sfambach/PALDump/hardware/shield/paldump-shield-bottom.png

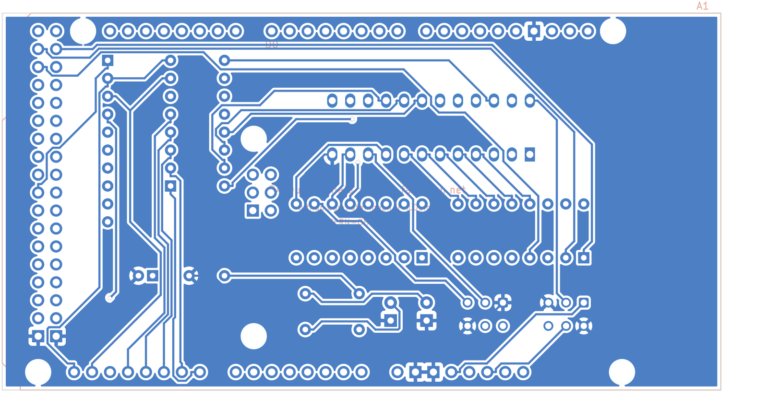
hardware/shield/paldump-shield-bottom.png
