sfambach/PALDump/hardware/shield/paldump-shield-schematic.png

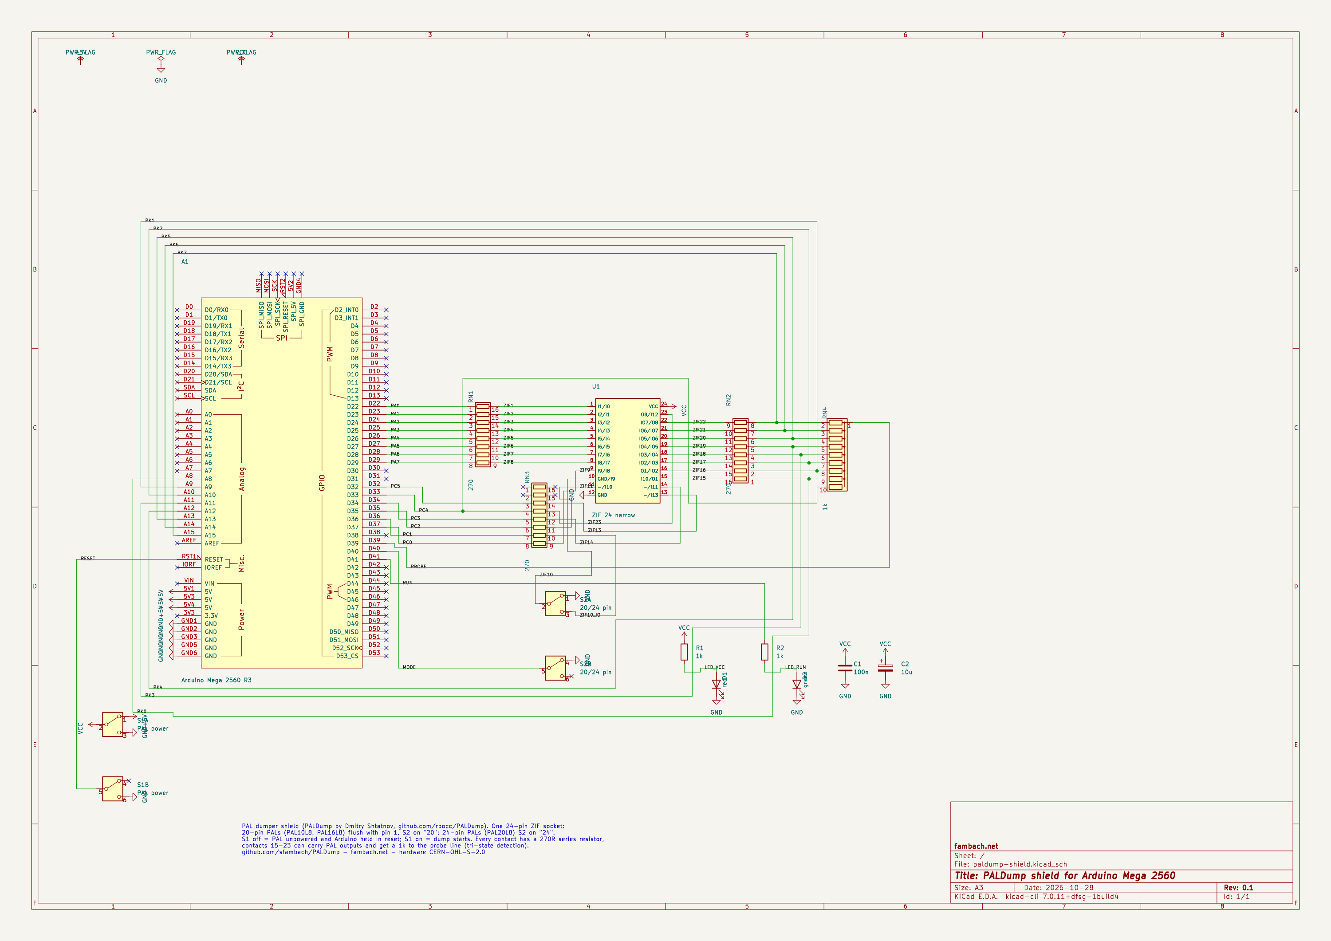
hardware/shield/paldump-shield-schematic.png
