sfambach/PALDump/hardware/shield/paldump-shield-schematic.pdf

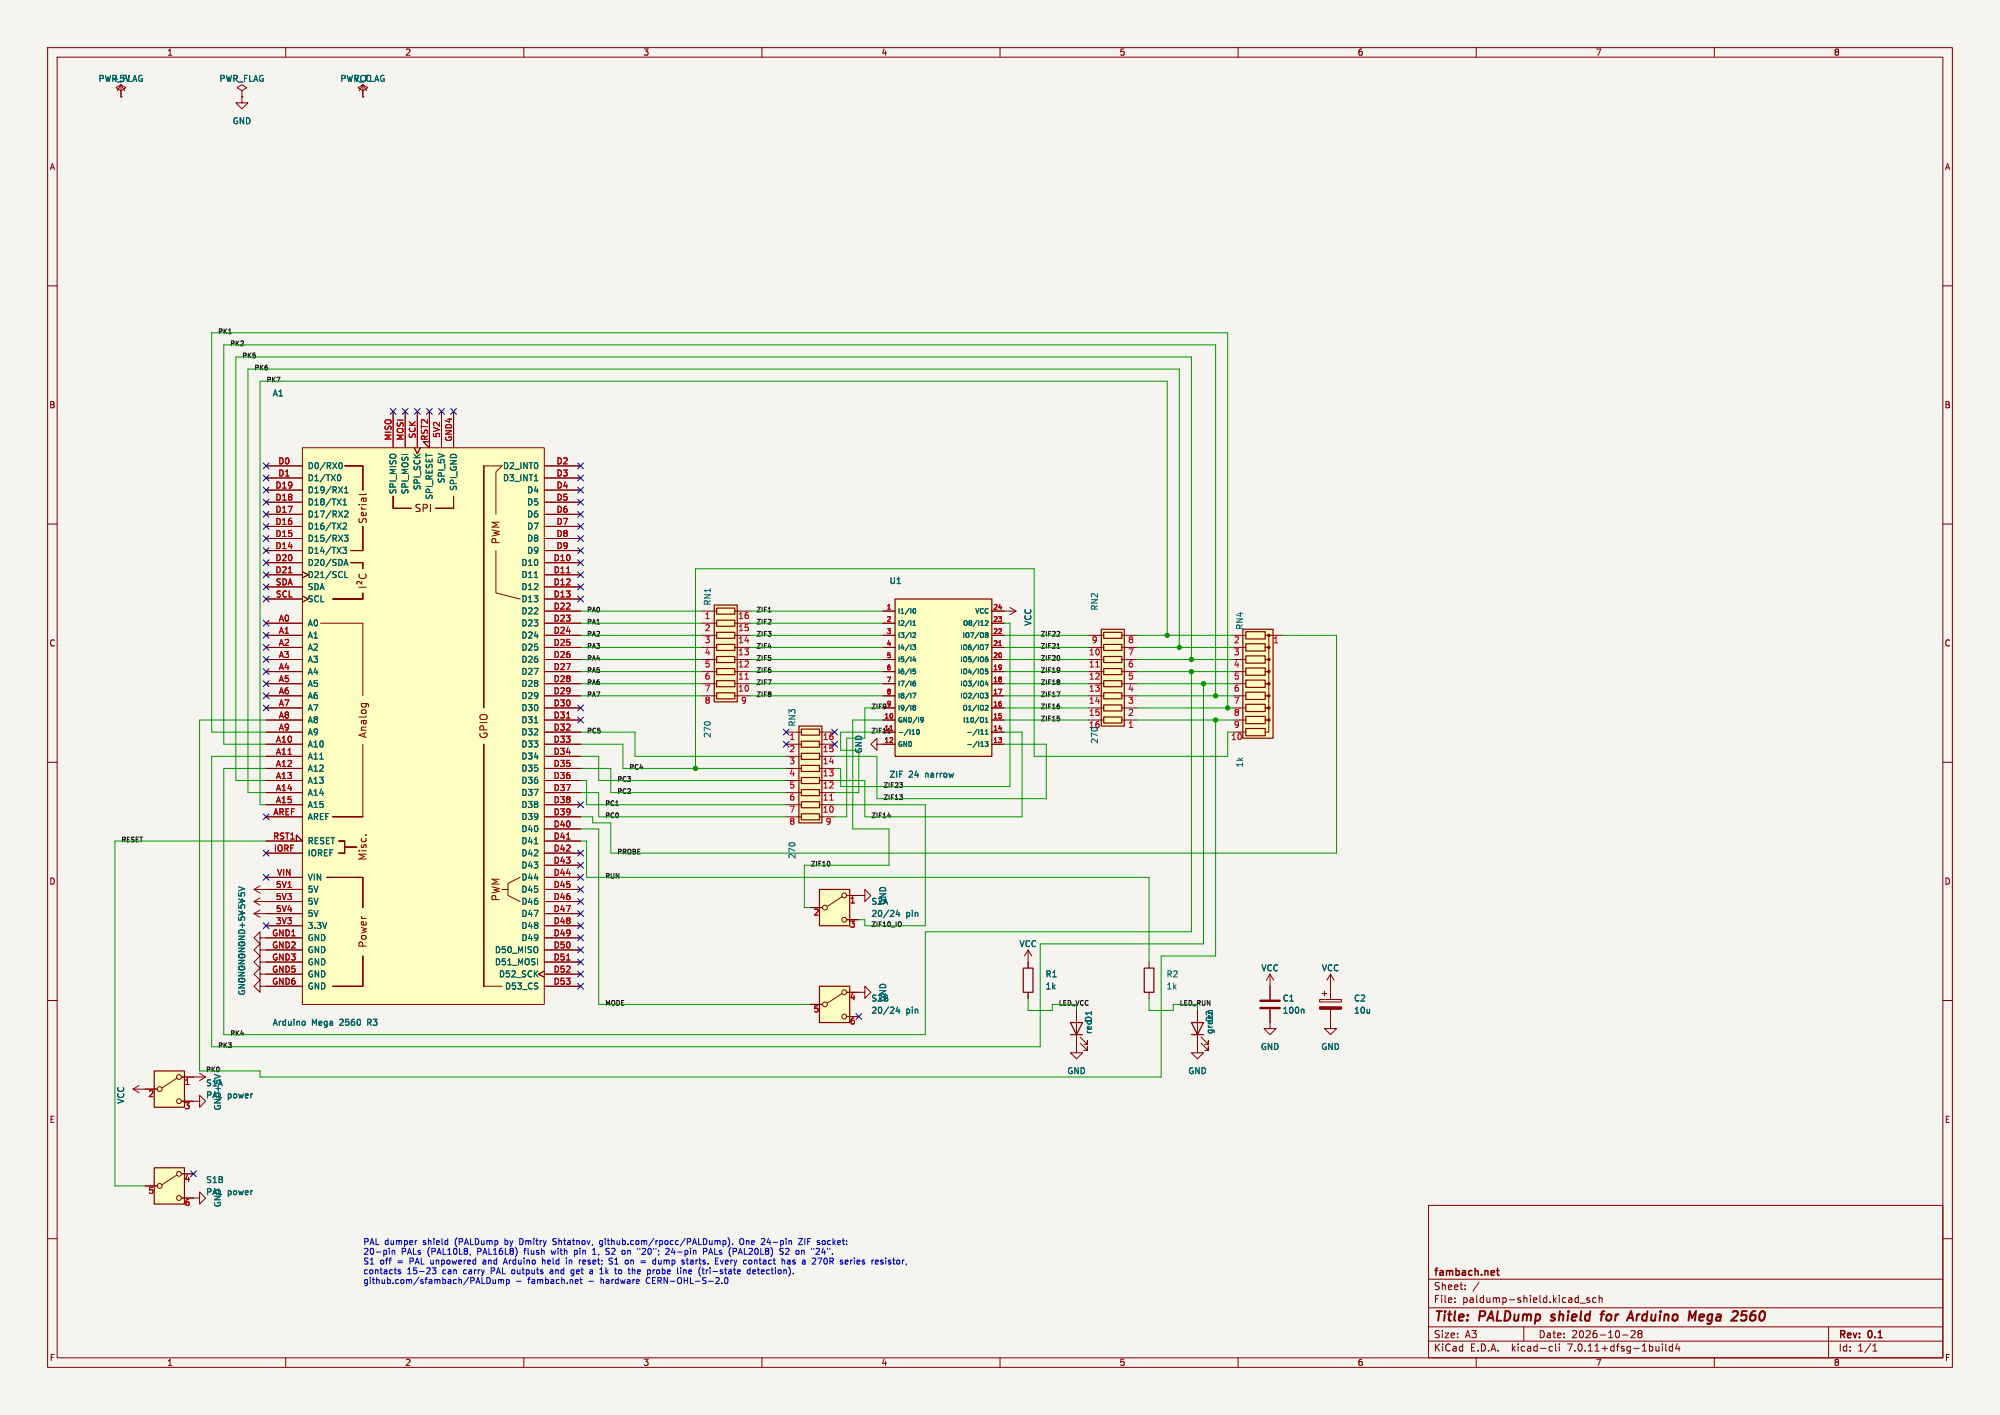
[picture p4: page 1]

Id: 1/1 Title: PALDump shield for Arduino Mega 2560
