sfambach/PALDump/hardware/shield/paldump-shield.kicad_pcb

## KiCad design hardware/shield/paldump-shield.kicad_pcb (2026-10-28)

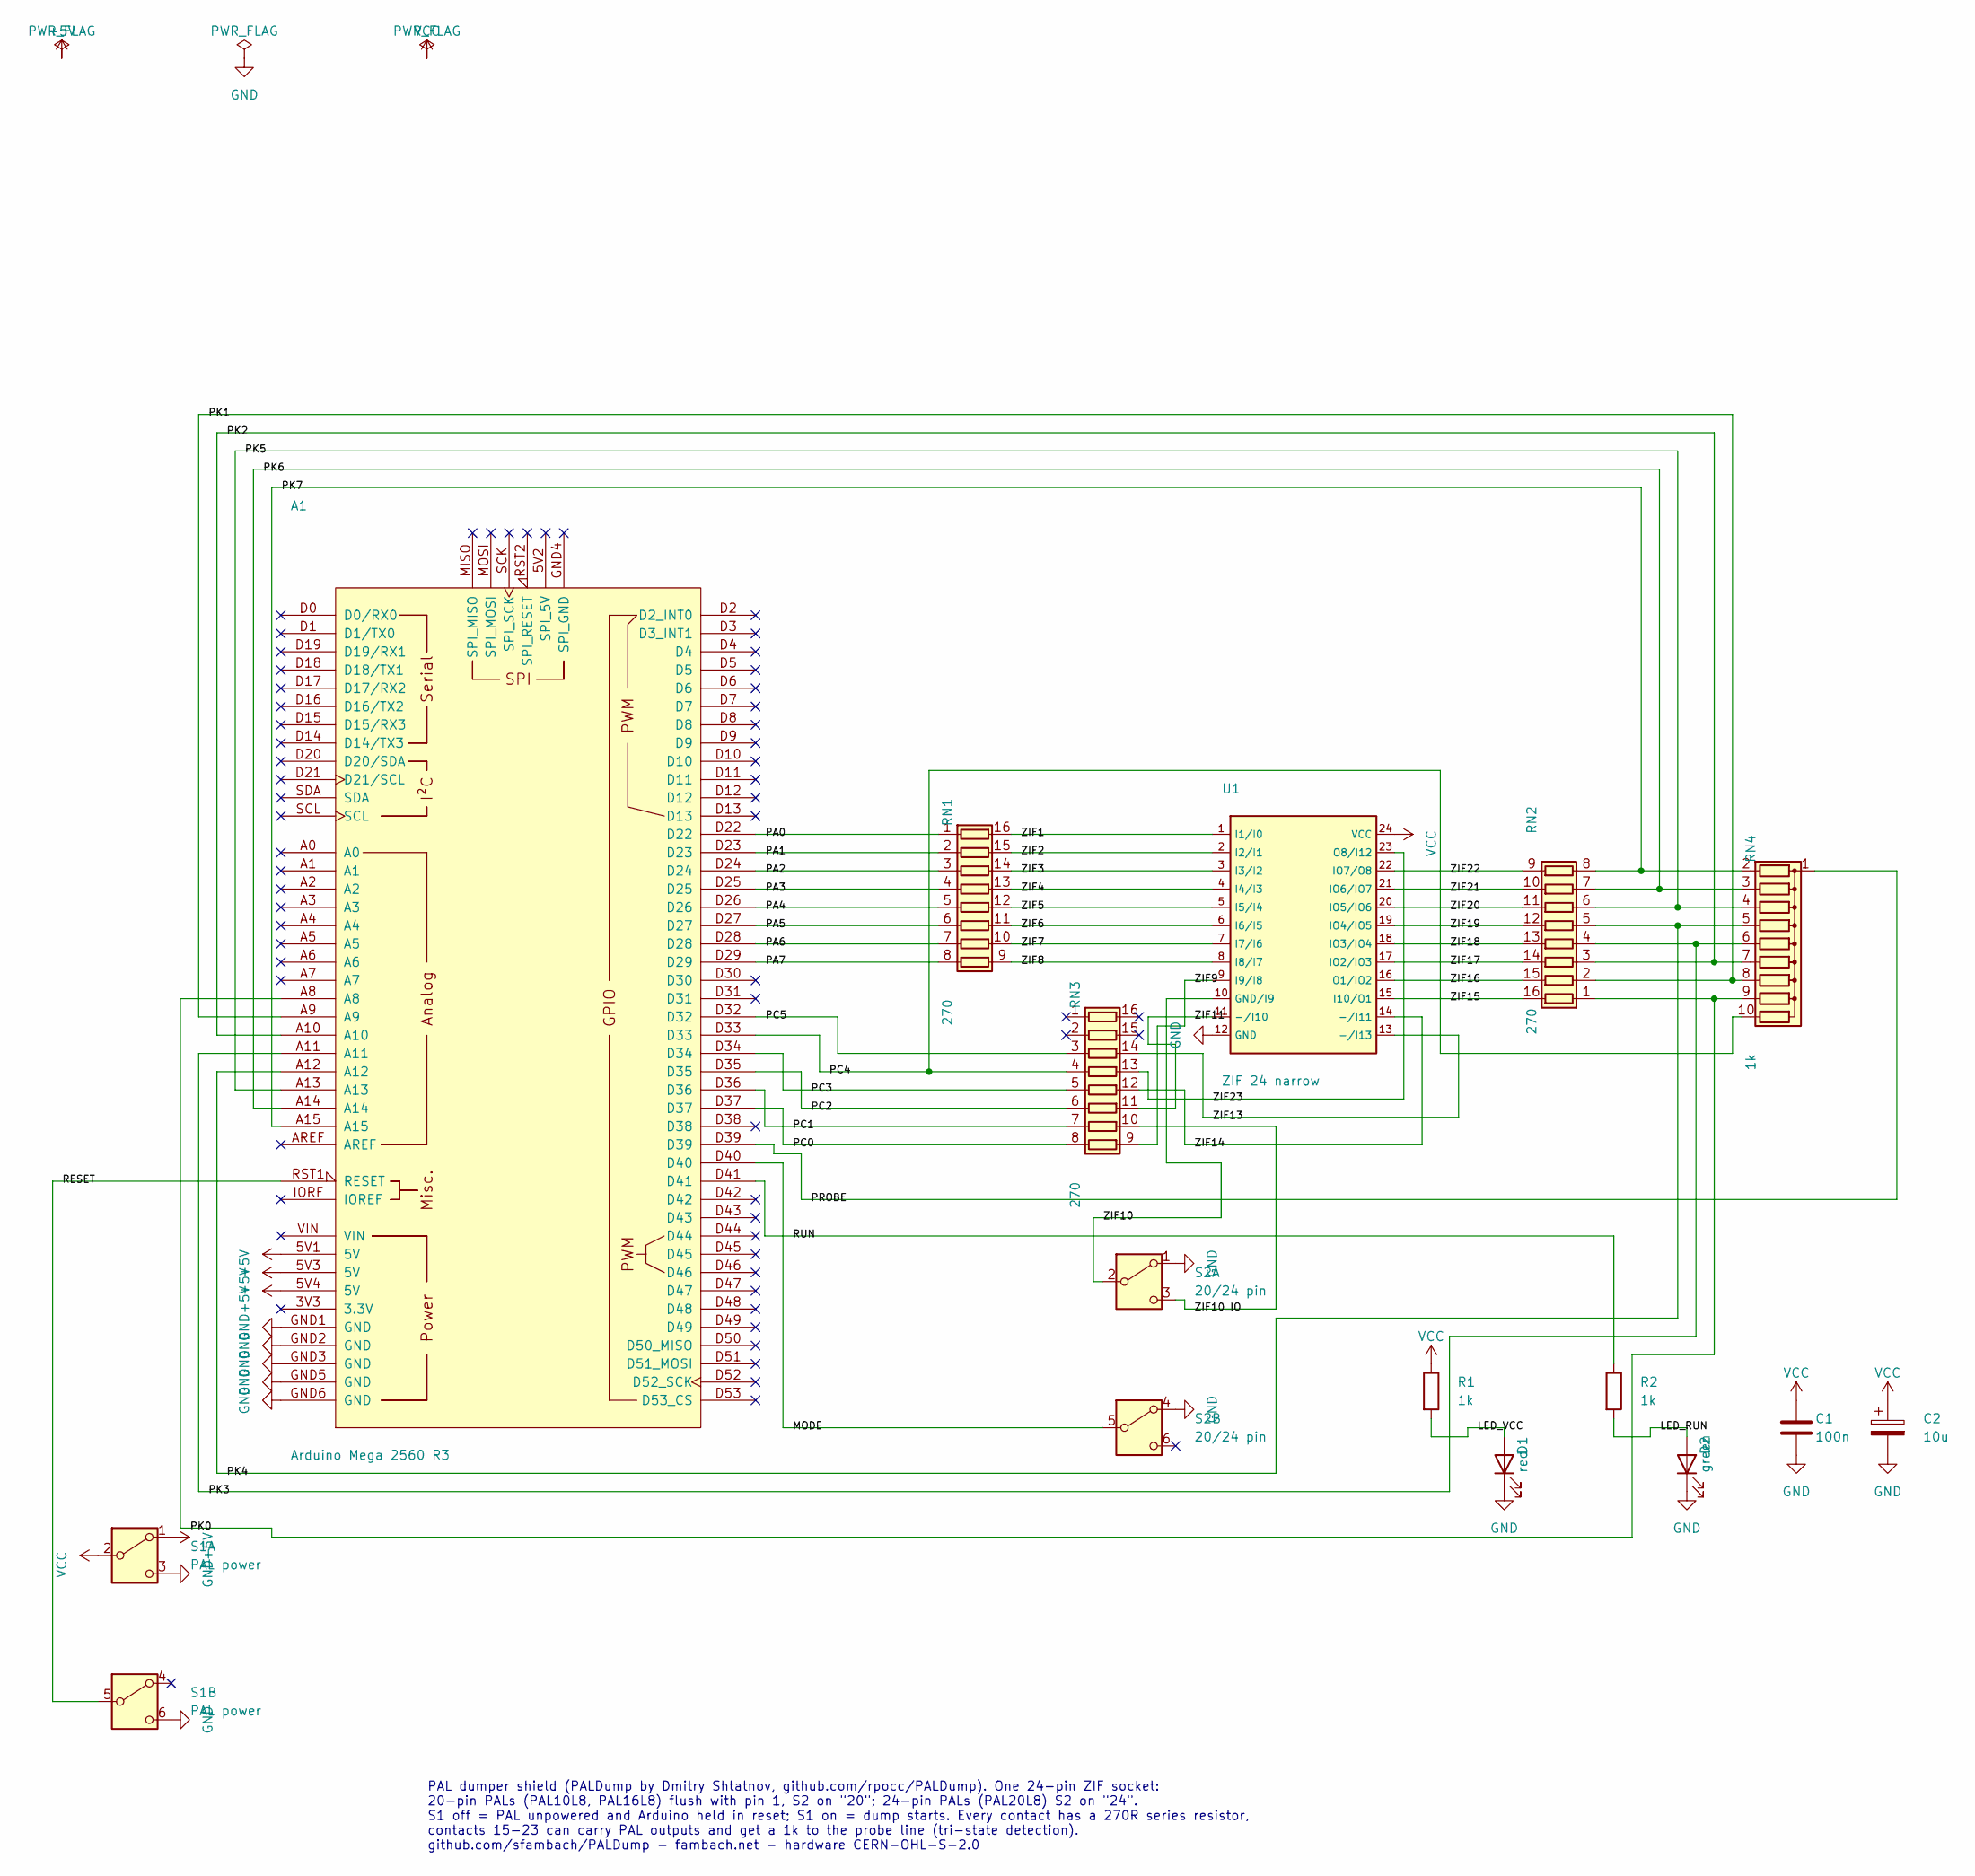
[picture p5: schematic paldump-shield.kicad_sch, PALDump shield for Arduino Mega 2560]

Parts:
A1: Arduino Mega 2560 R3; Arduino_Mega2560_R3_Shield
C1: 100n; C_Disc_D5.0mm_W2.5mm_P5.00mm
C2: 10u; CP_Radial_D5.0mm_P2.00mm
D1: red; LED_D3.0mm
D2: green; LED_D3.0mm
R1, R2: 1k; R_Axial_DIN0207_L6.3mm_D2.5mm_P7.62mm_Horizontal
RN1, RN2, RN3: 270; DIP-16_W7.62mm_Socket
RN4: 1k; R_Array_SIP10
S1: PAL power; SW_CK_JS202011CQN_DPDT_Straight
S2: 20/24 pin; SW_CK_JS202011CQN_DPDT_Straight
U1: ZIF 24 narrow; DIP_Socket-24_W4.3_W5.08_W7.62_W10.16_W10.9_3M_224-5248-00-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

Connections:
+5V: A1.5V1 (5V), A1.5V3 (5V), A1.5V4 (5V), S1.1 (A)
/LED_RUN: D2.2 (A), R2.2
/LED_VCC: D1.2 (A), R1.2
/MODE: A1.D40, S2.5 (B)
/PA0: A1.D22, RN1.1 (R1.1)
/PA1: A1.D23, RN1.2 (R2.1)
/PA2: A1.D24, RN1.3 (R3.1)
/PA3: A1.D25, RN1.4 (R4.1)
/PA4: A1.D26, RN1.5 (R5.1)
/PA5: A1.D27, RN1.6 (R6.1)
/PA6: A1.D28, RN1.7 (R7.1)
/PA7: A1.D29, RN1.8 (R8.1)
/PC0: A1.D37, RN3.8 (R8.1)
/PC1: A1.D36, RN3.7 (R7.1)
/PC2: A1.D35, RN3.6 (R6.1)
/PC3: A1.D34, RN3.5 (R5.1)
/PC4: A1.D33, RN3.4 (R4.1), RN4.10 (R9)
/PC5: A1.D32, RN3.3 (R3.1)
/PK0: A1.A8, RN2.1 (R1.1), RN4.9 (R8)
/PK1: A1.A9, RN2.2 (R2.1), RN4.8 (R7)
/PK2: A1.A10, RN2.3 (R3.1), RN4.7 (R6)
/PK3: A1.A11, RN2.4 (R4.1), RN4.6 (R5)
/PK4: A1.A12, RN2.5 (R5.1), RN4.5 (R4)
/PK5: A1.A13, RN2.6 (R6.1), RN4.4 (R3)
/PK6: A1.A14, RN2.7 (R7.1), RN4.3 (R2)
/PK7: A1.A15, RN2.8 (R8.1), RN4.2 (R1)
/PROBE: A1.D39, RN4.1 (common)
/RESET: A1.RST1 (RESET), S1.5 (B)
/RUN: A1.D41, R2.1
/VCC: C1.1, C2.1, R1.1, S1.2 (B), U1.24 (VCC)
/ZIF1: RN1.16 (R1.2), U1.1 (I1/I0)
/ZIF2: RN1.15 (R2.2), U1.2 (I2/I1)
/ZIF3: RN1.14 (R3.2), U1.3 (I3/I2)
/ZIF4: RN1.13 (R4.2), U1.4 (I4/I3)
/ZIF5: RN1.12 (R5.2), U1.5 (I5/I4)
/ZIF6: RN1.11 (R6.2), U1.6 (I6/I5)
/ZIF7: RN1.10 (R7.2), U1.7 (I7/I6)
/ZIF8: RN1.9 (R8.2), U1.8 (I8/I7)
/ZIF9: RN3.9 (R8.2), U1.9 (I9/I8)
/ZIF10: S2.2 (B), U1.10 (GND/I9)
/ZIF10_IO: RN3.10 (R7.2), S2.3 (C)
/ZIF11: RN3.11 (R6.2), U1.11 (-/I10)
/ZIF13: RN3.14 (R3.2), U1.13 (-/I13)
/ZIF14: RN3.12 (R5.2), U1.14 (-/I11)
/ZIF15: RN2.16 (R1.2), U1.15 (I10/O1)
/ZIF16: RN2.15 (R2.2), U1.16 (O1/IO2)
/ZIF17: RN2.14 (R3.2), U1.17 (IO2/IO3)
/ZIF18: RN2.13 (R4.2), U1.18 (IO3/IO4)
/ZIF19: RN2.12 (R5.2), U1.19 (IO4/IO5)
/ZIF20: RN2.11 (R6.2), U1.20 (IO5/IO6)
/ZIF21: RN2.10 (R7.2), U1.21 (IO6/IO7)
/ZIF22: RN2.9 (R8.2), U1.22 (IO7/O8)
/ZIF23: RN3.13 (R4.2), U1.23 (O8/I12)
GND: A1.GND1 (GND), A1.GND2 (GND), A1.GND3 (GND), A1.GND5 (GND), A1.GND6 (GND), C1.2, C2.2, D1.1 (K), D2.1 (K), S1.3 (C), S1.6 (C), S2.1 (A), S2.4 (A), U1.12 (GND)

Notes on the sheet:
PAL dumper shield (PALDump by Dmitry Shtatnov, github.com/rpocc/PALDump). One 24-pin ZIF socket: 20-pin PALs (PAL10L8, PAL16L8) flush with pin 1, S2 on "20"; 24-pin PALs (PAL20L8) S2 on "24". S1 off = PAL unpowered and Arduino held in reset; S1 on = dump starts. Every contact has a 270R series resi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

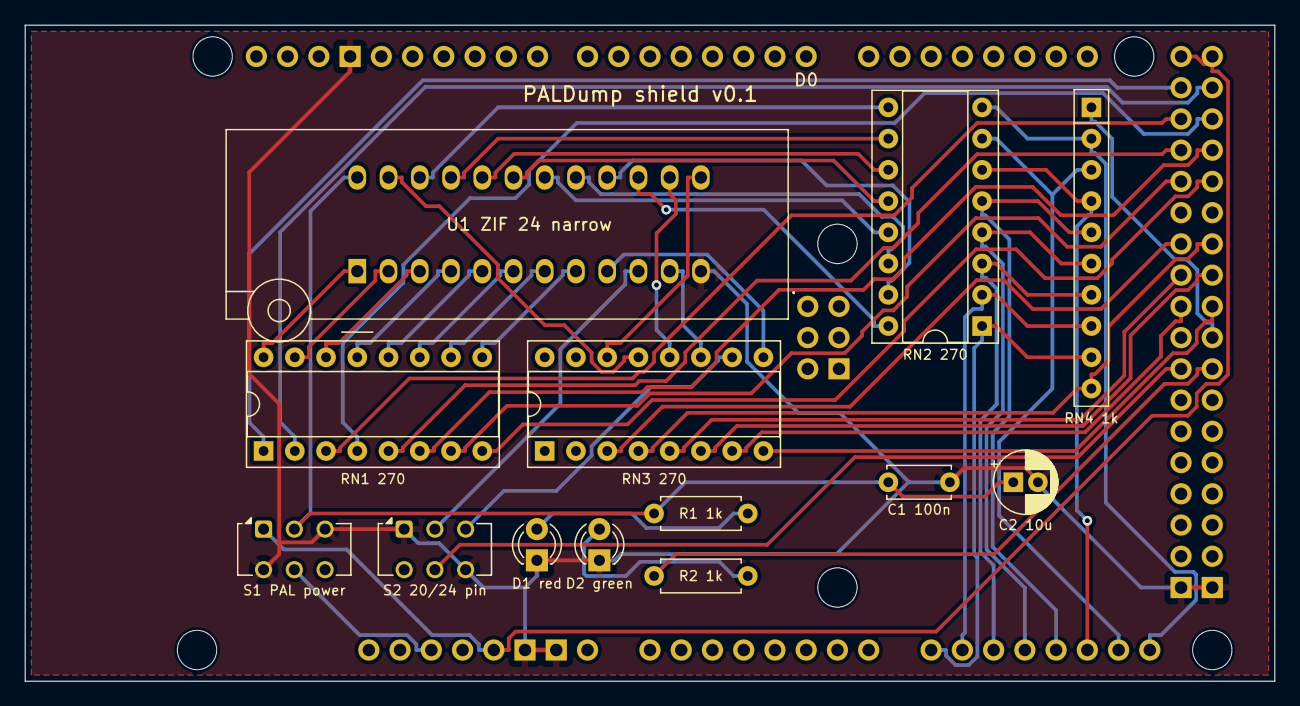
[picture p6: board paldump-shield.kicad_pcb from above]

Board: 2 copper layers, 101.6 x 53.3 mm, 14 parts (0 on the bottom side), 54 nets.
